Schnetzi8/dmx-led-bar/README.md

# dmx-led-bar
A dmx controllable strip of LEDs. With Web Interface for configuration.
