Schnetzi8/dmx-led-bar/Sample-QR-Codes.docx

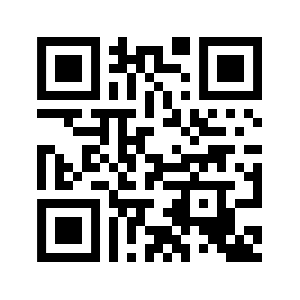
[picture p1: figure]
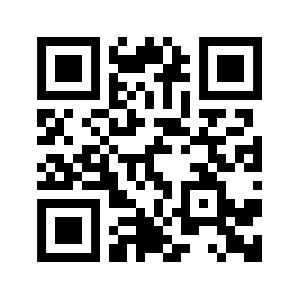
[picture p2: figure]

MainController | LampController
