Schnetzi8/dmx-led-bar/KiCad/SerialToDmx.kicad_pcb

## KiCad design KiCad/SerialToDmx.kicad_pcb (2024-08-14)

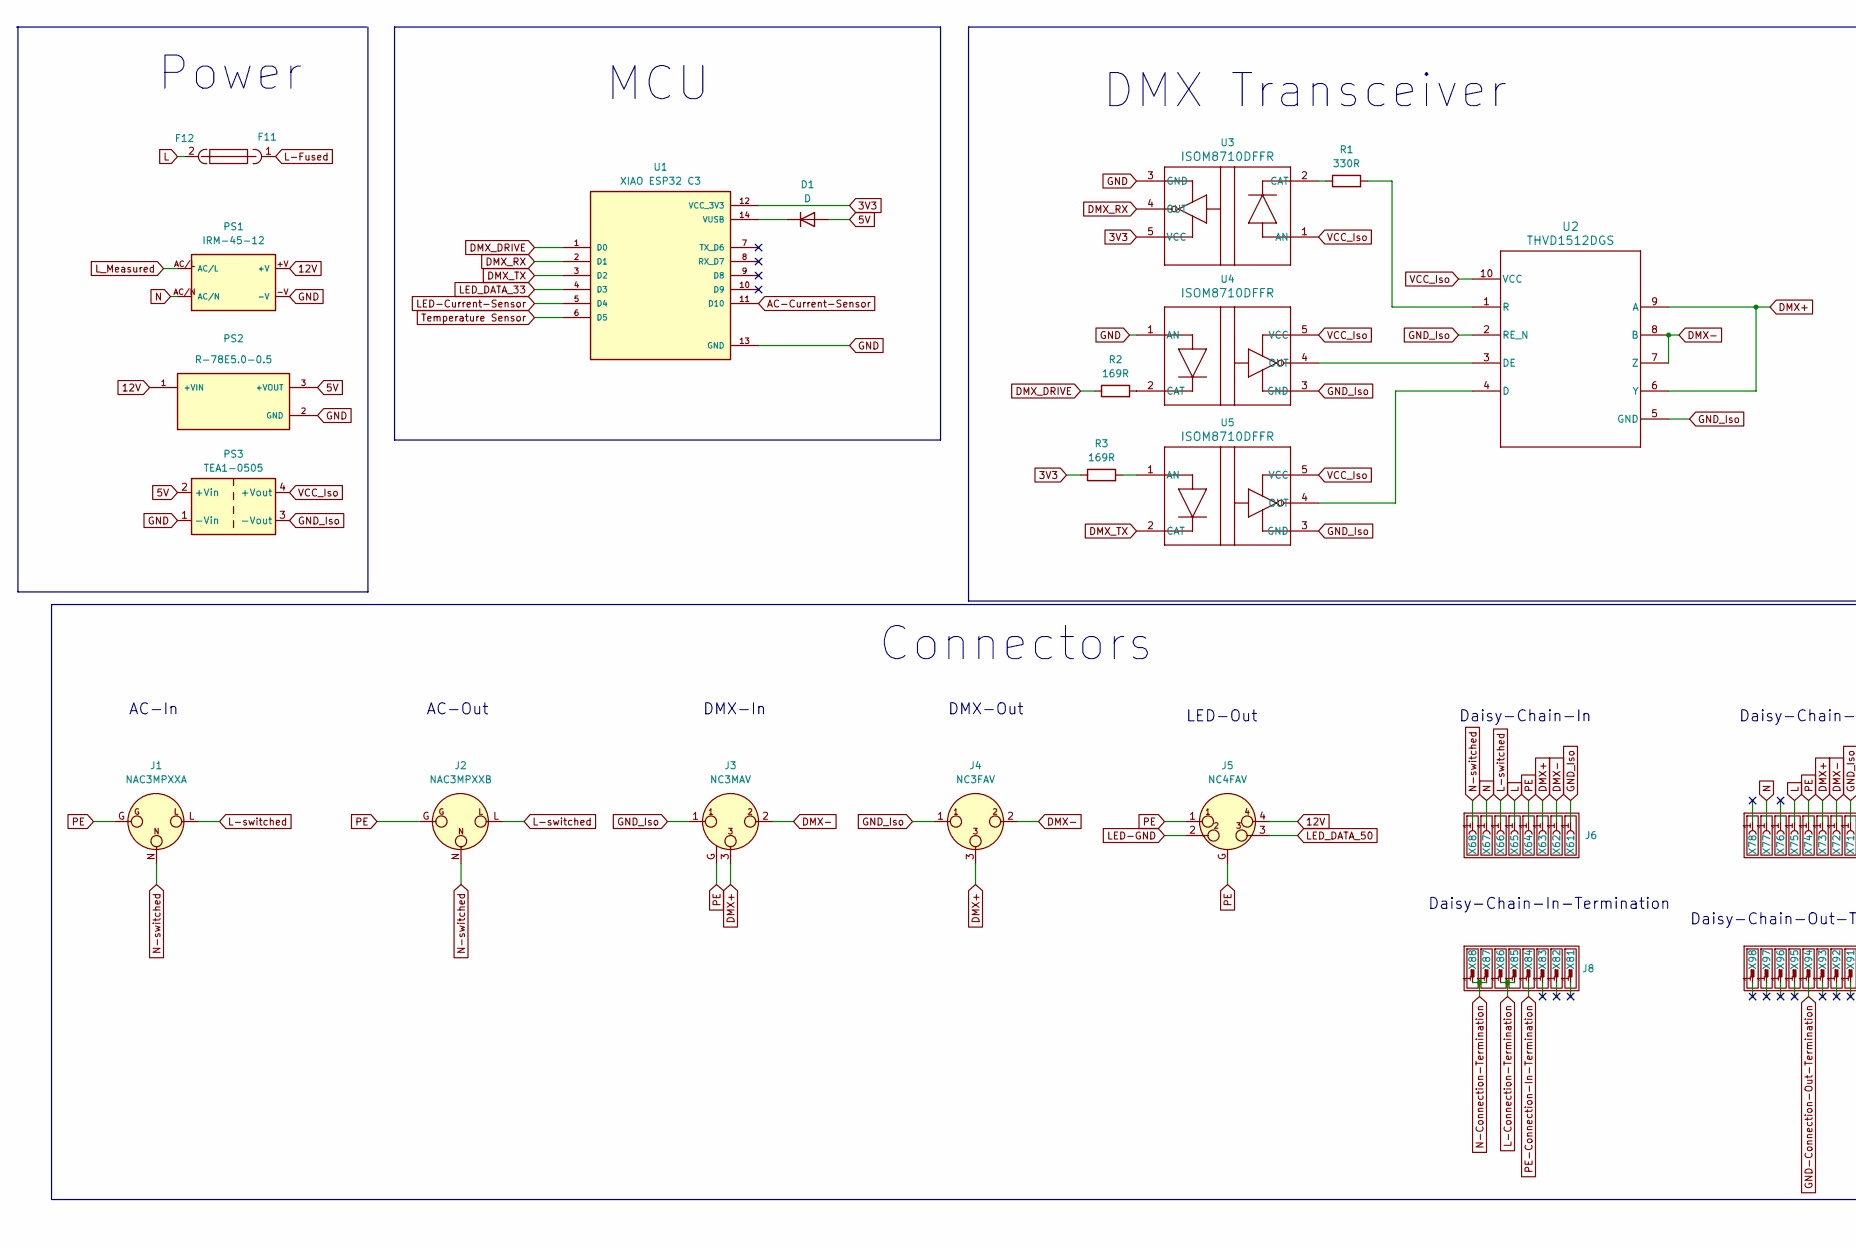
[picture p3: schematic SerialToDmx.kicad_sch, part in row 1, column 1]

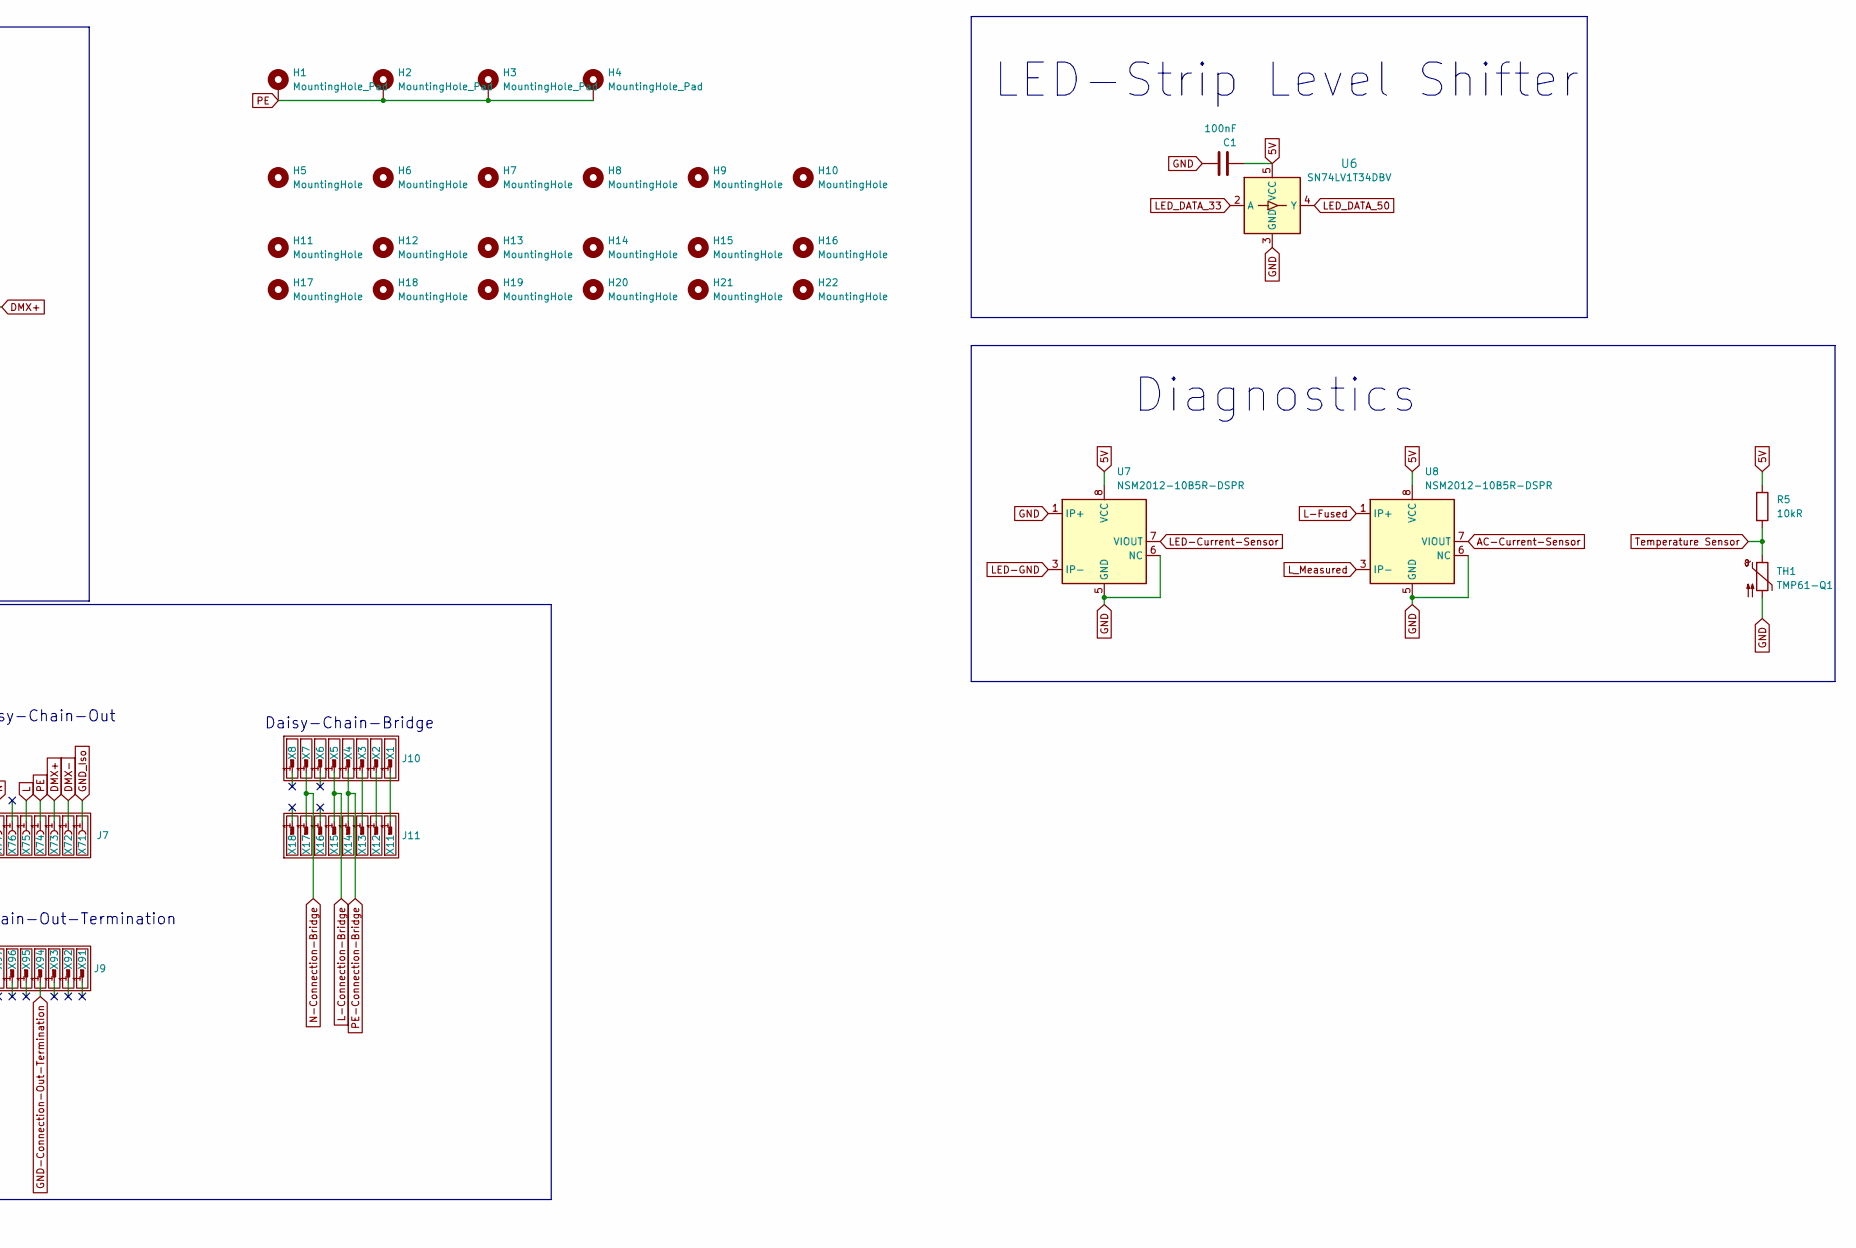
[picture p4: schematic SerialToDmx.kicad_sch, part in row 1, column 2]

Parts:
C1: 100nF; C_0402_1005Metric_Pad0.74x0.62mm_HandSolder
D1: D; R_0402_1005Metric
F11: 01110501Z; fuseholder_111_501_Part1
F12: 01110501Z; fuseholder_111_501_Part2
H1, H2, H3, H4: MountingHole_Pad; MountingHole_3.2mm_M3_DIN965_Pad
H5, H6, H7, H8, H9, H10: MountingHole; MountingHole_3.2mm_M3
H11, H12, H13, H14, H15, H16, H17, H18, H19, H20, H21, H22: MountingHole; mouse-bite-2mm-slot
J1: NAC3MPXXA; DigiKey_Part_Number 708-1341-ND
J2: NAC3MPXXB; PARTREV N/A
J3: NC3MAV
J4: NC3FAV
J5: NC4FAV
J6, J7: Faston_01x08_socket
J8, J9, J10, J11: Faston_01x08_pin
PS1: IRM-45-12; CONV_IRM-45-12; PARTREV NA
PS2: R-78E5.0-0.5; CONV_R-78E5.0-0.5; PARTREV 4
PS3: TEA1-0505; Converter_DCDC_TRACO_TEA1-xxxx_THT
R1: 330R; R_0402_1005Metric
R2, R3: 169R; R_0402_1005Metric
R5: 10kR; R_0402_1005Metric
TH1: TMP61-Q1; R_0402_1005Metric
U1: XIAO ESP32 C3; XIAO-Generic-Thruhole-14P-2.54-21X17.8MM; PARTREV 23/05/2022
U2: THVD1512DGS; DGS0010A_N
U3, U4, U5: ISOM8710DFFR; ISOM8710; PARTREV 6
U6: SN74LV1T34DBV; SOT-23-5
U7, U8: NSM2012-10B5R-DSPR; SOIC-8_3.9x4.9mm_P1.27mm
X1, X2, X3, X4, X5, X6, X7, X8, X11, X12, X13, X14, X15, X16, X17, X18, X81, X82, X83, X84, X85, X86, X87, X88, X91, X92, X93, X94, X95, X96, X97, X98: 1217861-1; Faston_01x01_pin
X61, X62, X63, X64, X65, X66, X67, X68, X71, X72, X73, X74, X75, X76, X77, X78: 63994-1; Faston_01x01_socket

Connections:
3V3: R3.1, U1.12 (VCC_3V3), U3.5 (VCC)
5V: C1.2, D1.2 (A), PS2.3 (+VOUT), PS3.2 (+Vin), R5.1, U6.5 (VCC), U7.8 (VCC), U8.8 (VCC)
12V: J5.4, PS1.+V, PS2.1 (+VIN)
AC-Current-Sensor: U1.11 (D10), U8.7 (VIOUT)
DMX+: J3.3, J4.3, U2.6 (Y), U2.9 (A), X63.1, X73.1
DMX-: J3.2, J4.2, U2.7 (Z), U2.8 (B), X62.1, X72.1
DMX_DRIVE: R2.1, U1.1 (D0)
DMX_RX: U1.2 (D1), U3.4 (OUT)
DMX_TX: U1.3 (D2), U5.2 (CAT)
GND: C1.1, PS1.-V, PS2.2 (GND), PS3.1 (-Vin), TH1.2, U1.13 (GND), U3.3 (GND), U4.1 (AN), U6.3 (GND), U7.1 (IP+), U7.2 (IP+), U7.5 (GND), U7.6 (NC), U8.5 (GND), U8.6 (NC)
GND-Connection-Out-Termination: X94.1
GND_Iso: J3.1, J4.1, PS3.3 (-Vout), U2.2 (RE_N), U2.5 (GND), U4.3 (GND), U5.3 (GND), X61.1, X71.1
L: F12.2, X65.1, X75.1
L-Connection-Bridge: X5.1, X15.1
L-Connection-Termination: X85.1, X86.1
L-Fused: F11.1, U8.1 (IP+), U8.2 (IP+)
L-switched: J1.L, J2.L, X66.1
LED-Current-Sensor: U1.5 (D4), U7.7 (VIOUT)
LED-GND: J5.2, U7.3 (IP-), U7.4 (IP-)
LED_DATA_33: U1.4 (D3), U6.2 (A)
LED_DATA_50: J5.3, U6.4 (Y)
L_Measured: PS1.AC/L, U8.3 (IP-), U8.4 (IP-)
N: PS1.AC/N, X67.1, X77.1
N-Connection-Bridge: X7.1, X17.1
N-Connection-Termination: X87.1, X88.1
N-switched: J1.N, J2.N, X68.1
unnamed: D1.1 (K), U1.14 (VUSB)
unnamed: U2.4 (D), U5.4 (OUT)
unnamed: U2.3 (DE), U4.4 (OUT)
unnamed: R1.2, U2.1 (R)
unnamed: R1.1, U3.2 (CAT)
unnamed: R2.2, U4.2 (CAT)
unnamed: R3.2, U5.1 (AN)
unnamed: X1.1, X11.1
unnamed: X2.1, X12.1
unnamed: X3.1, X13.1
PE: H1.1, H2.1, H3.1, H4.1, J1.G, J2.G, J3.G, J5.1, J5.G, X64.1, X74.1
PE-Connection-Bridge: X4.1, X14.1
PE-Connection-In-Termination: X84.1
Temperature Sensor: R5.2, TH1.1, U1.6 (D5)
VCC_Iso: PS3.4 (+Vout), U2.10 (VCC), U3.1 (AN), U4.5 (VCC), U5.5 (VCC)

Notes on the sheet:
LED-Out
Daisy-Chain-In-Termination
Diagnostics
AC-In
Daisy-Chain-Out-Termination
DMX Transceiver
DMX-Out
MCU
Daisy-Chain-Out
Daisy-Chain-Bridge
LED-Strip Level Shifter
Power
Daisy-Chain-In
DMX-In
Connectors
AC-Out

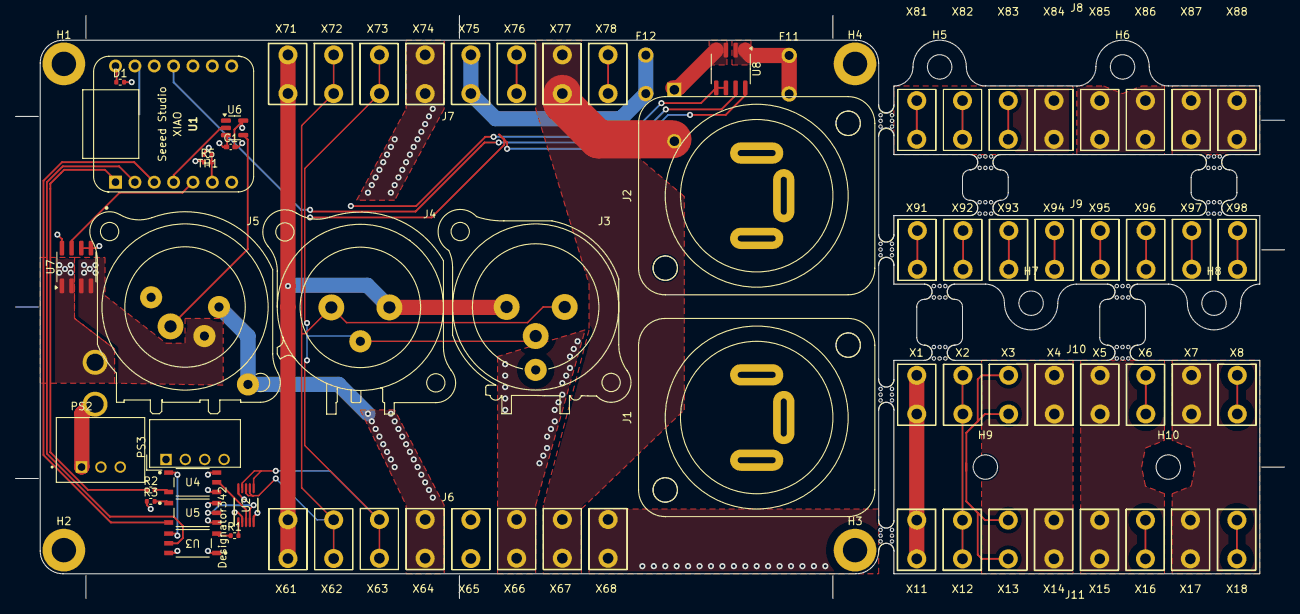
[picture p5: board SerialToDmx.kicad_pcb from above]

Board: 4 copper layers, 166.5 x 76.5 mm, 101 parts (1 on the bottom side), 39 nets.
