Schnetzi8/dmx-led-bar/(commit log)

2024-07-30 Started Work on Conn Box V2
    [SerialToDmx.kicad_pcb, SerialToDmx.kicad_sch]
2024-07-31 Started on Mounting Holes for Terminators and Bridge
    [SerialToDmx.kicad_pcb, SerialToDmx.kicad_sch]
2024-07-31 Improved Layout for Case
    [SerialToDmx.kicad_pcb, SerialToDmx.kicad_sch]
2024-08-13 Adjusted Board for new Case
2024-08-13 Revert "Adjusted Board for new Case"
    This reverts commit 228f85c15c617e8d061b070415350dd353ddd87a.
2024-08-13 With Files
    [SerialToDmx.kicad_pcb, SerialToDmx.kicad_sch]
2024-08-14 Switched Female and Male XLR 3-Pin Connectors
    [SerialToDmx.kicad_pcb, SerialToDmx.kicad_sch]
